CosmicSail/Detecteur-de-muons/Schéma électronique/image001.png

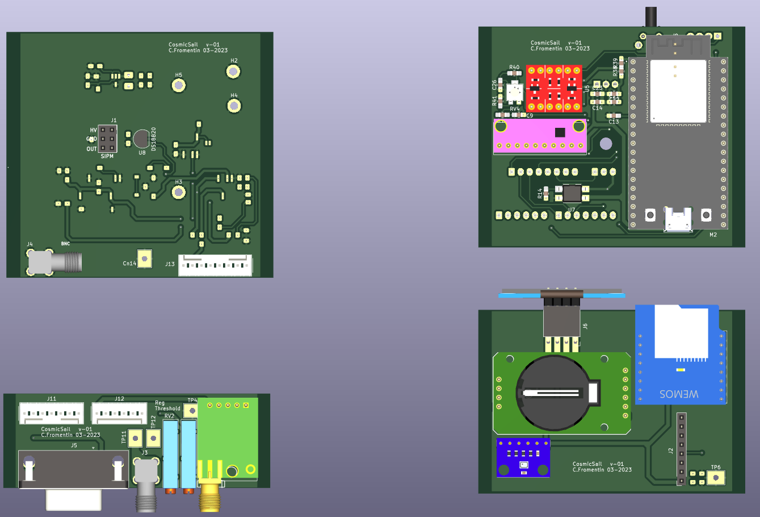
Schéma électronique/image001.png
