CosmicSail/Detecteur-de-muons/Schéma électronique/image004(1).png

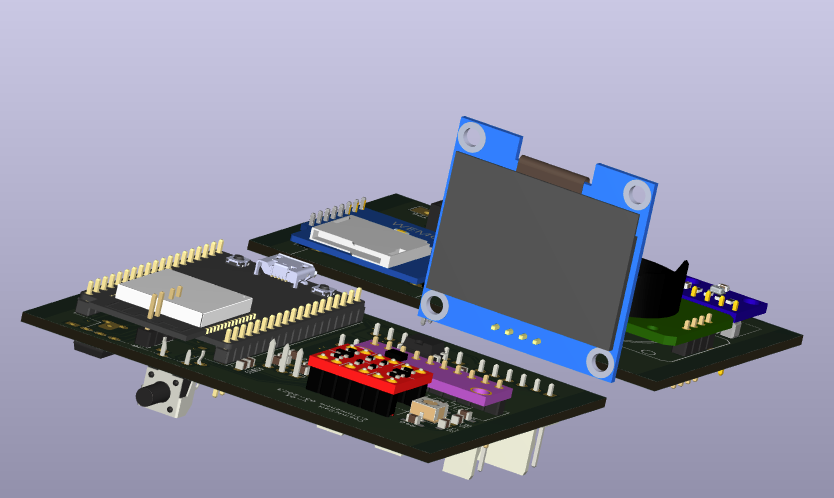
Schéma électronique/image004(1).png
