CosmicSail/Detecteur-de-muons/Schéma électronique/Carte_SIPM.pdf

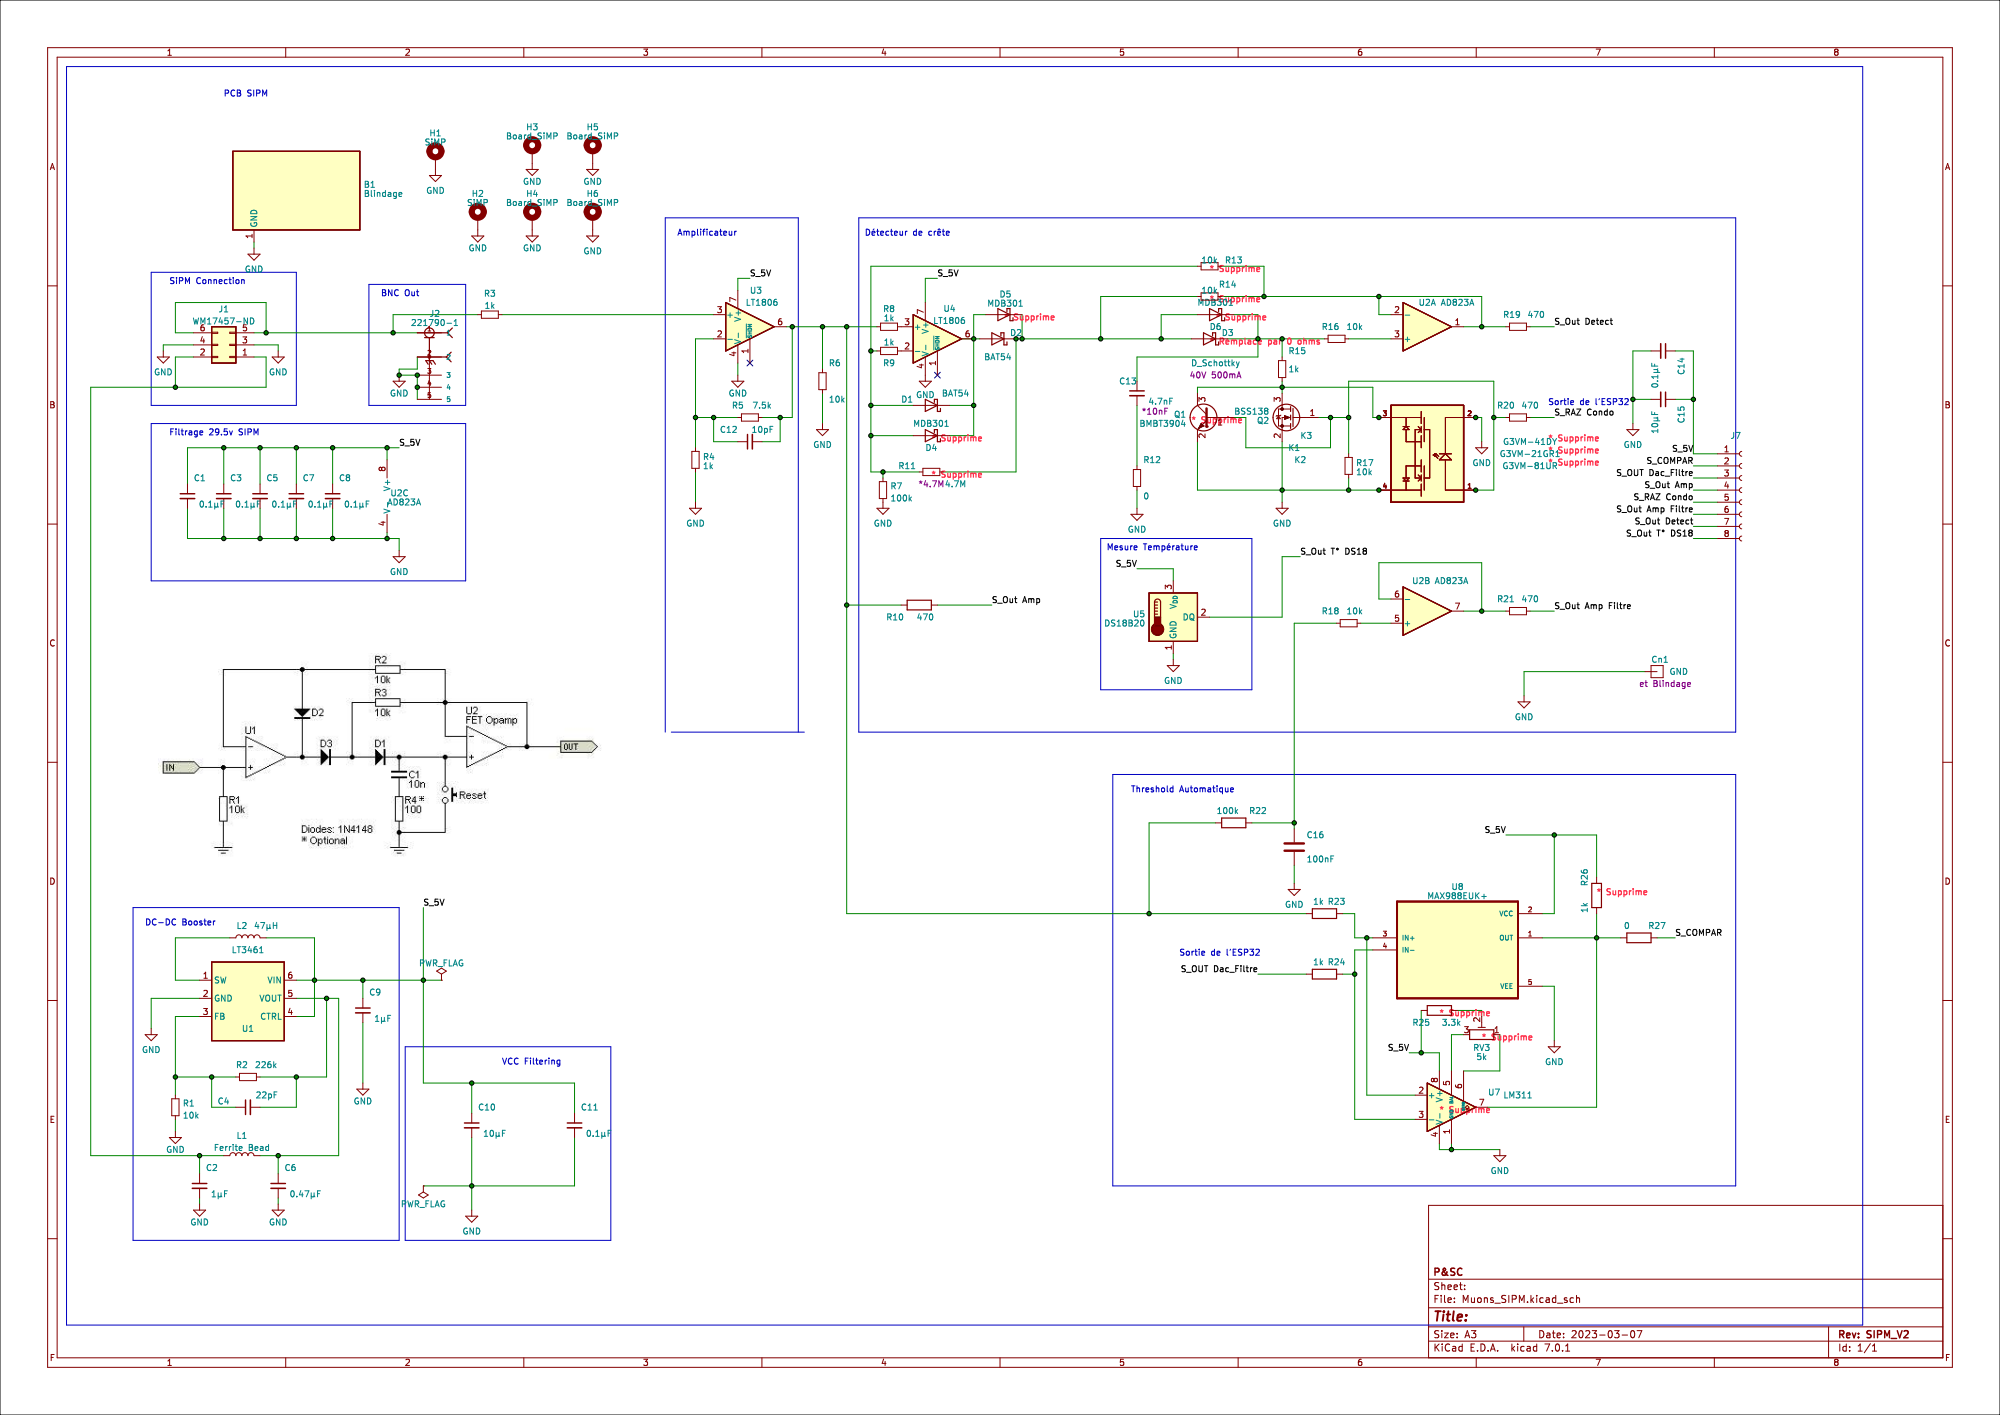
[picture p11: page 1]
