CosmicSail/Detecteur-de-muons/Schéma électronique/Coté_Composant.pdf

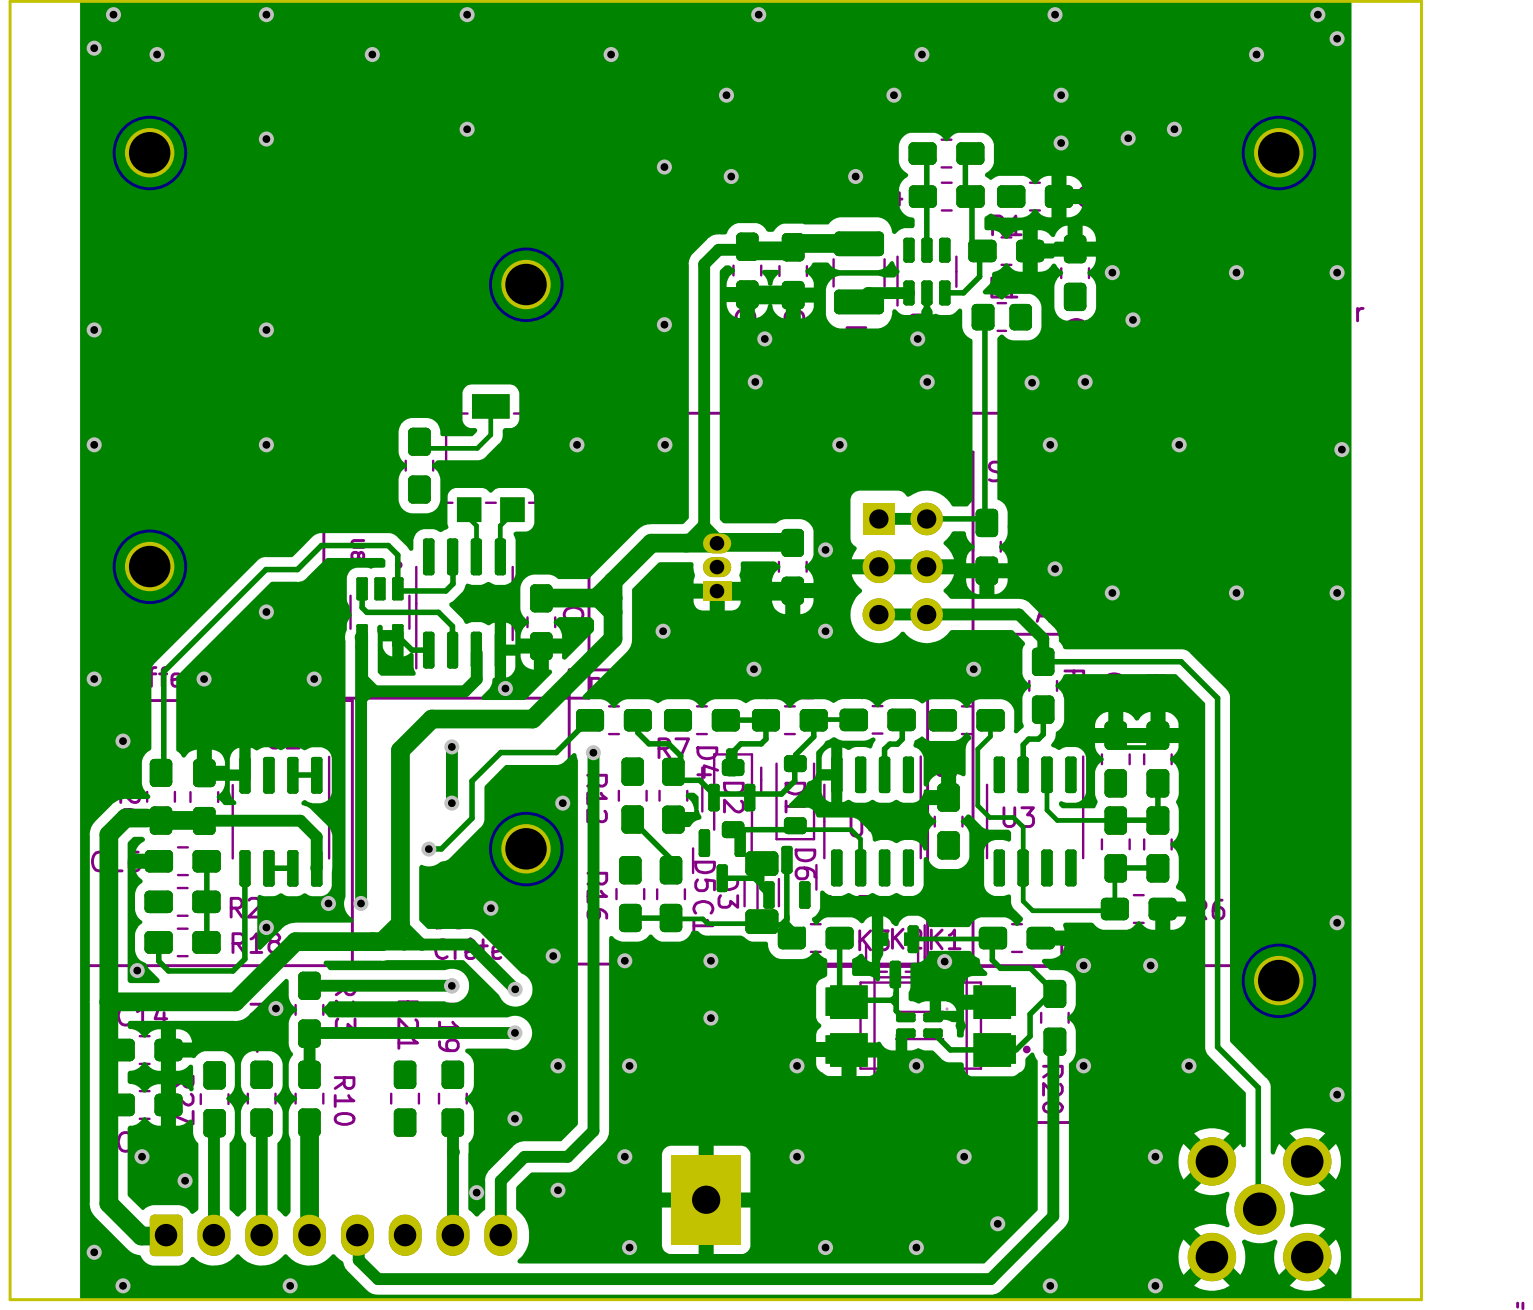
[picture p12: page 1]
