CosmicSail/Detecteur-de-muons/Schéma électronique/Coté_Dessus.pdf

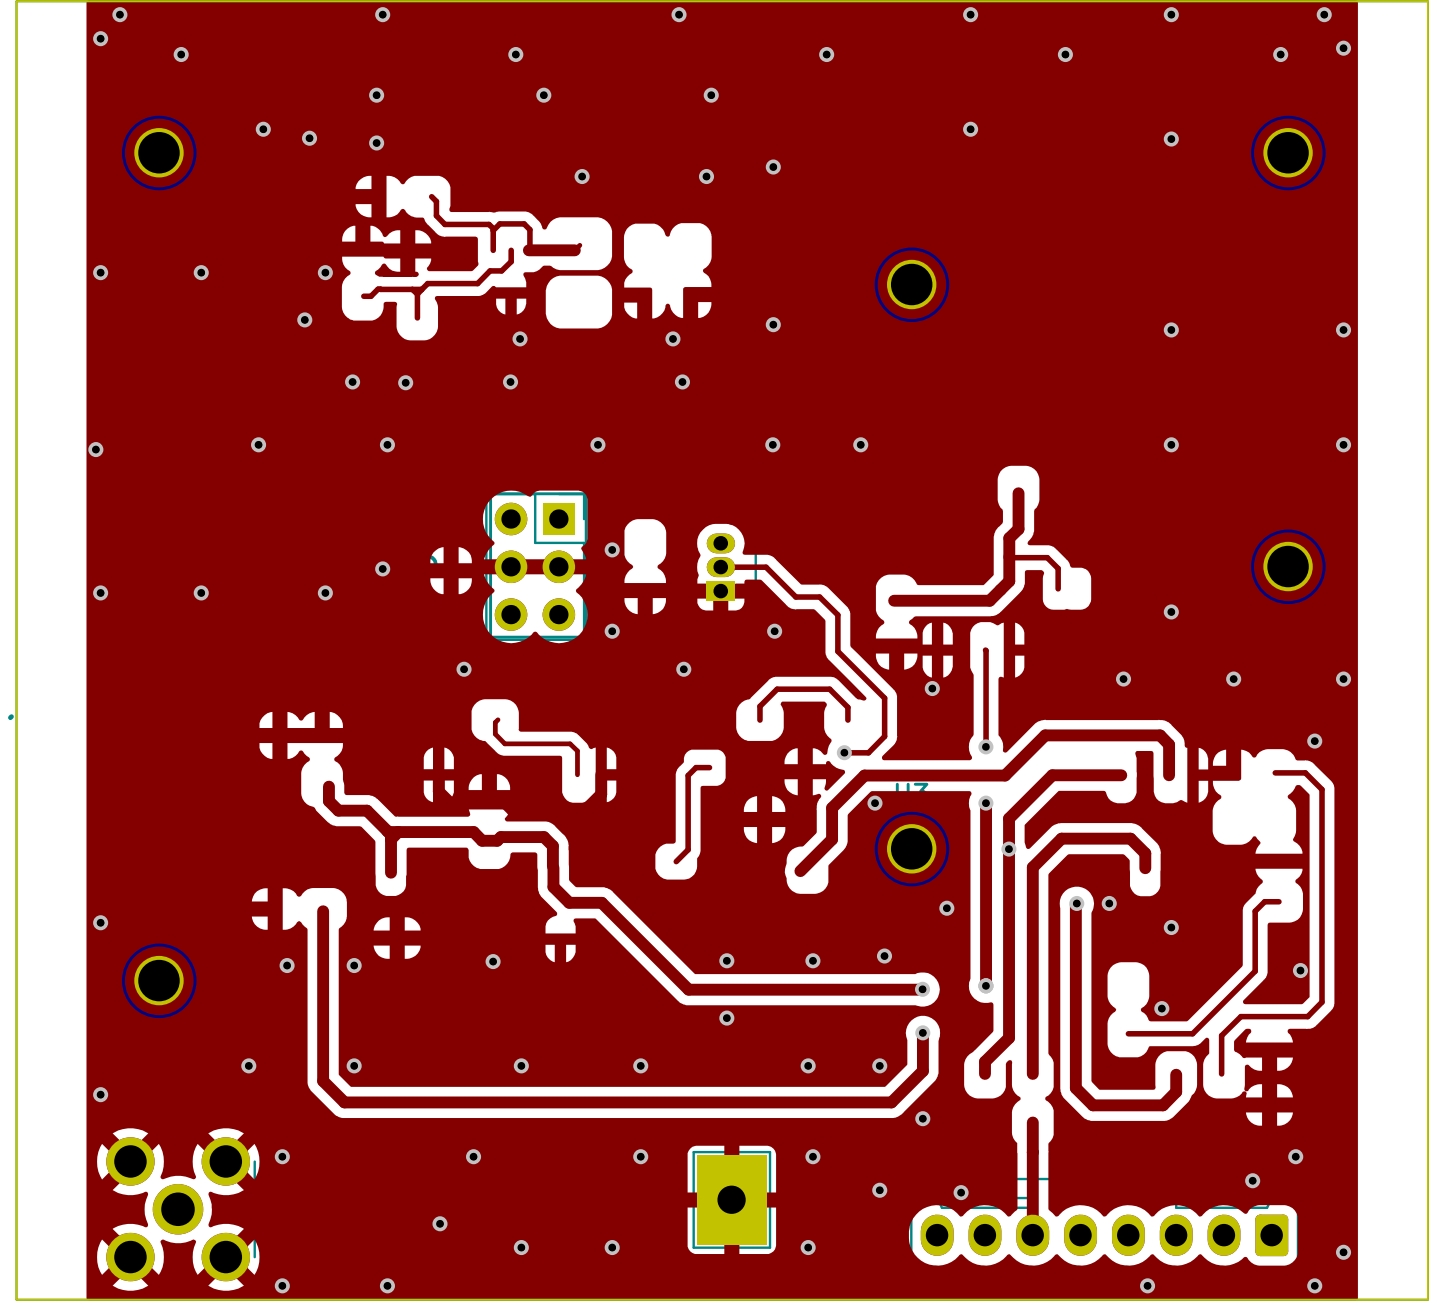
[picture p13: page 1]
