CosmicSail/Detecteur-de-muons/Schéma électronique/image002.png

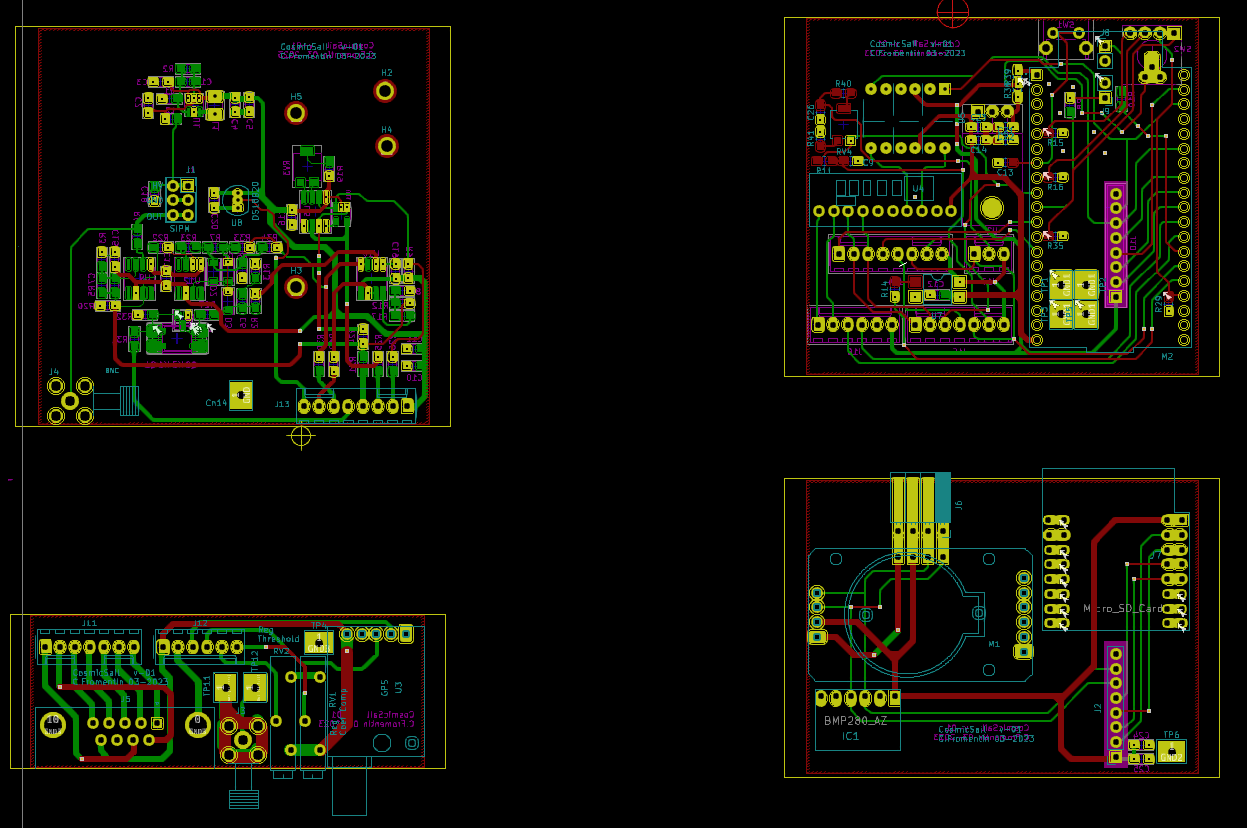
Schéma électronique/image002.png
