CosmicSail/Detecteur-de-muons/Schéma électronique/image003.png

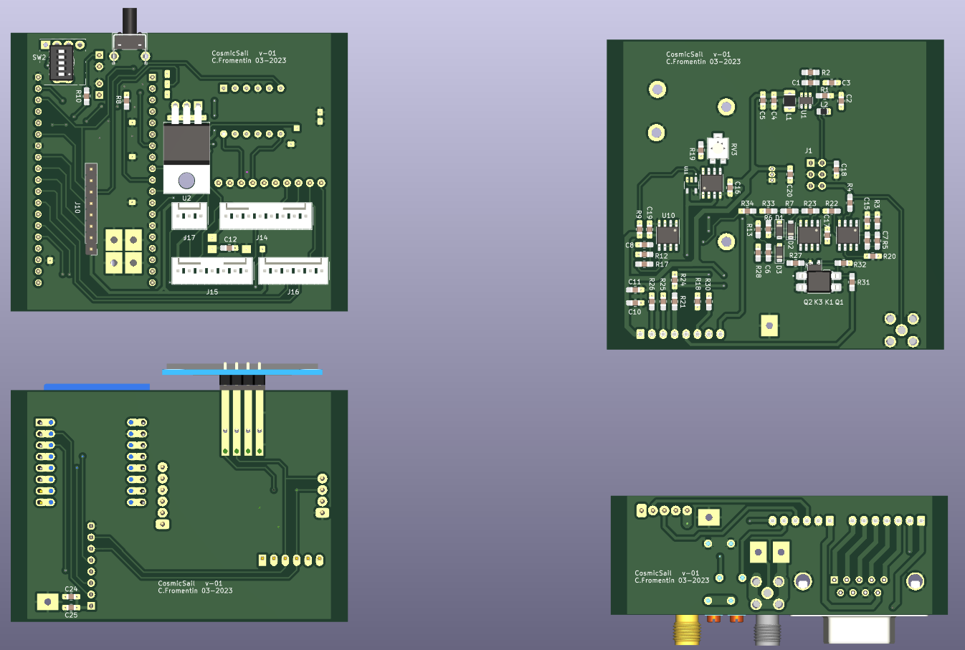
Schéma électronique/image003.png
